Dulan24/Function-Generator/report/Function_Generator[1].pptx

## Analog Function Generator

Group 25
- 200148M DOMBAWALA D.P.C.L.
- 200356A LOKUGEEGANA D.L.
- 200511V RANASINGHE R.A.R.L
- 200741B YAPA Y.A.N.T.

## Circuit Diagram

Triangular and Saw-tooth

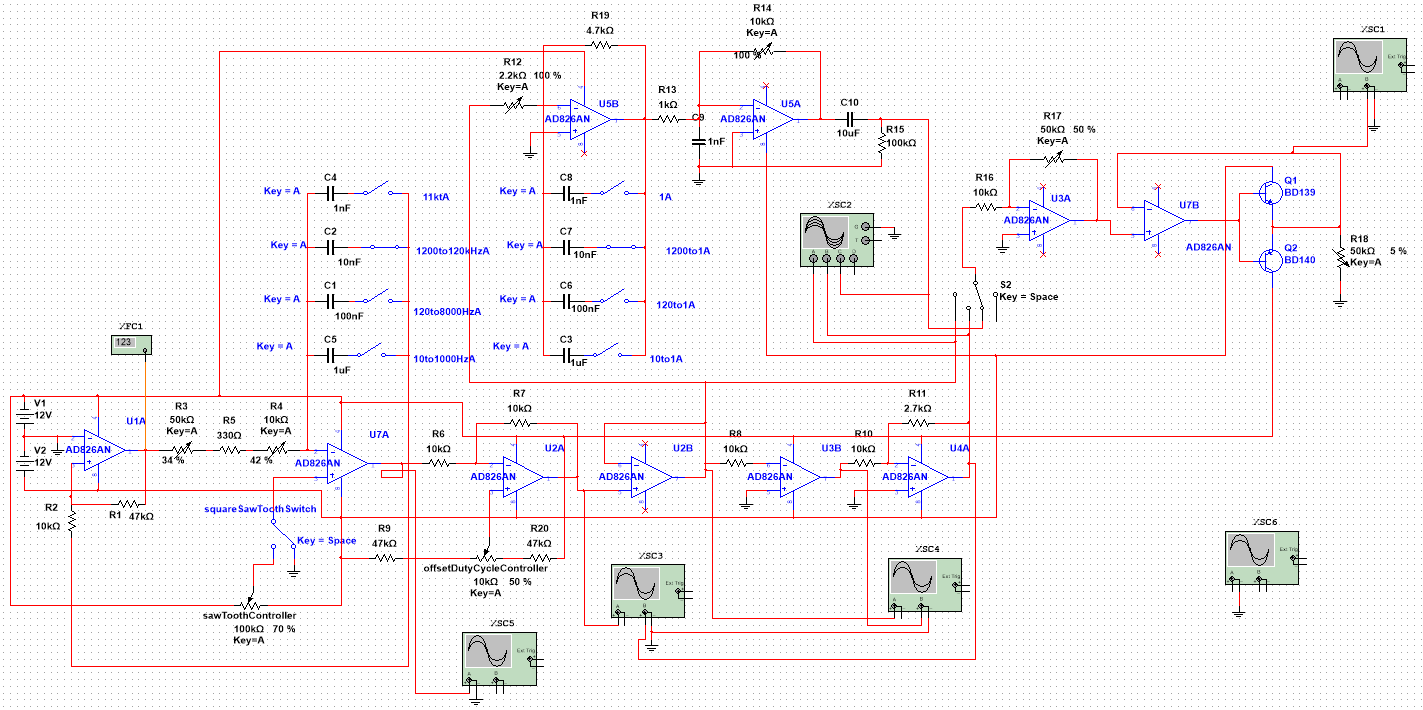
[picture p1: figure]

Sine wave

Square wave

## Circuit

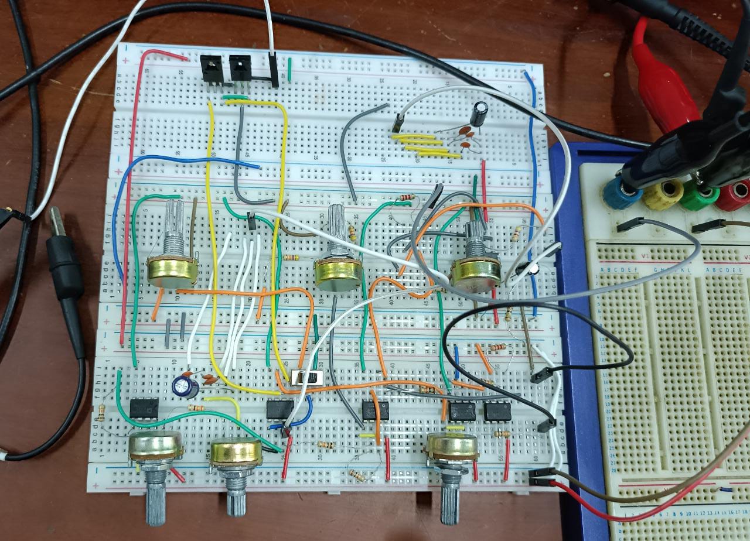
[picture p2: figure]

## PCB Design

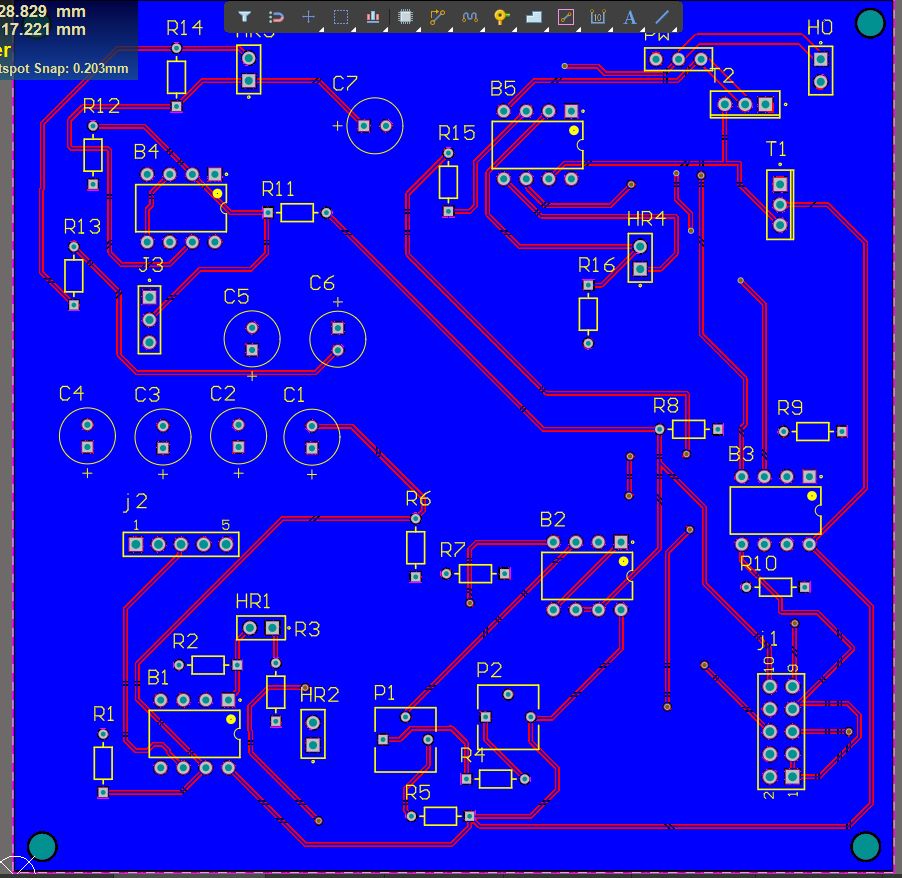
[picture p3: figure]
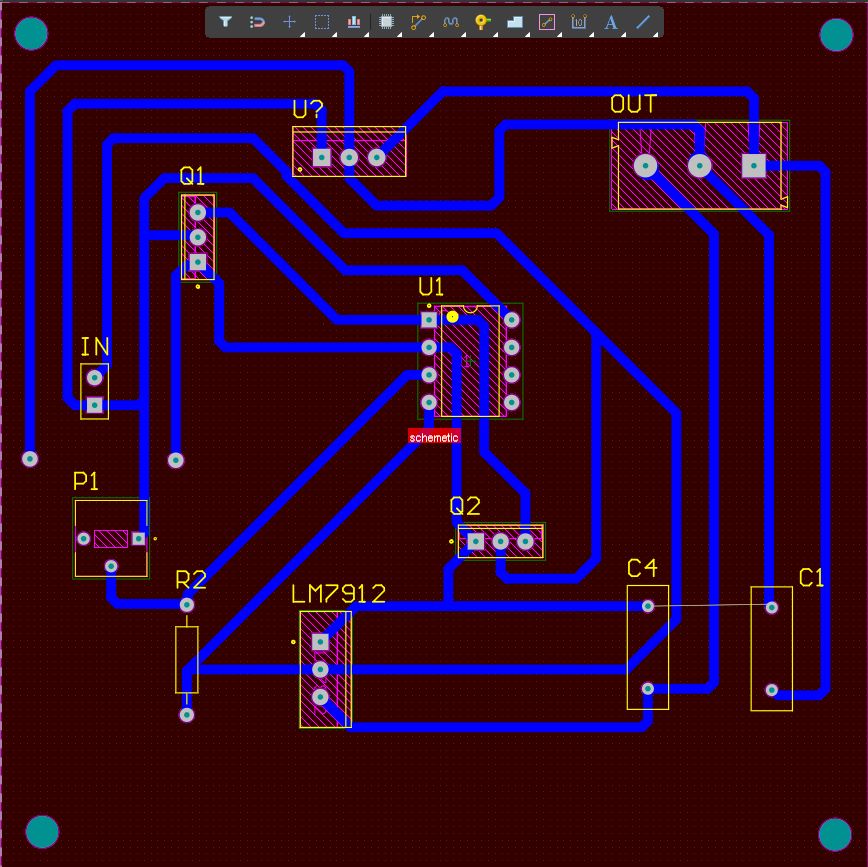
[picture p4: figure]
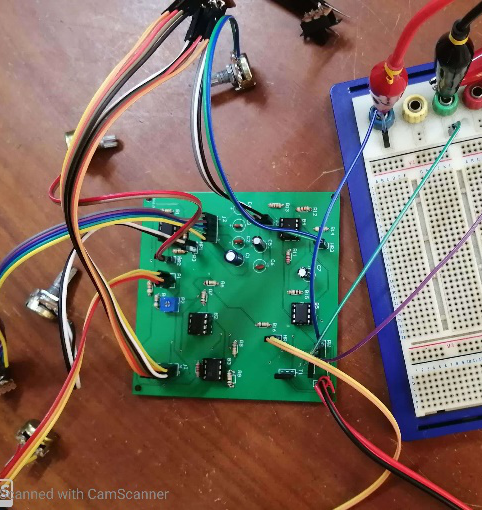
[picture p5: figure]

Main PCB

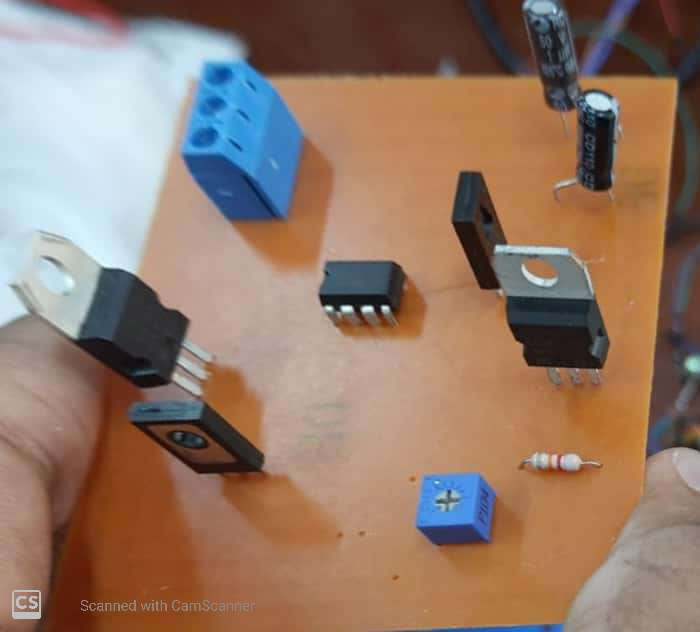
[picture p6: figure]

Power Supply Circuit

## Block Diagram

Triangular and saw-tooth

Frequency Selection

Square wave

Duty Cycle Change

Saw-tooth / Triangle Selection

Schmitt Trigger

Integrator

Triangular wave

Offset

Comparator

Attenuator

Triangular Saw-tooth wave

Mode Selection

Sine wave

Frequency Selection

Integrator

Square wave

Amplifier

Push Pull
circuit

Sine wave

Amplifier

## Triangular & saw tooth wave

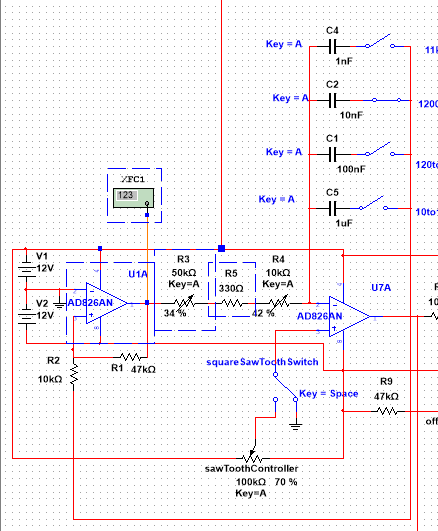
[picture p7: figure]

Using Schmitt trigger circuit and integrator circuit, triangular wave and saw-tooth wave

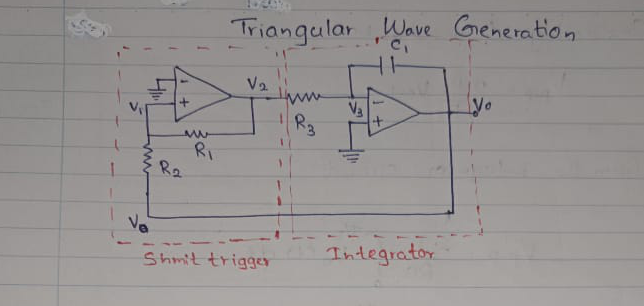
[picture p8: figure]

## Triangular & saw tooth wave

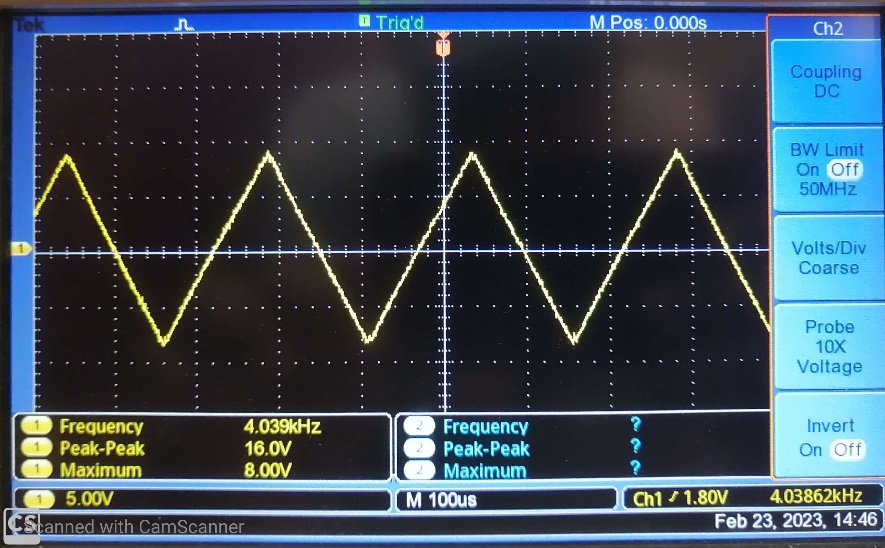
[picture p9: figure]
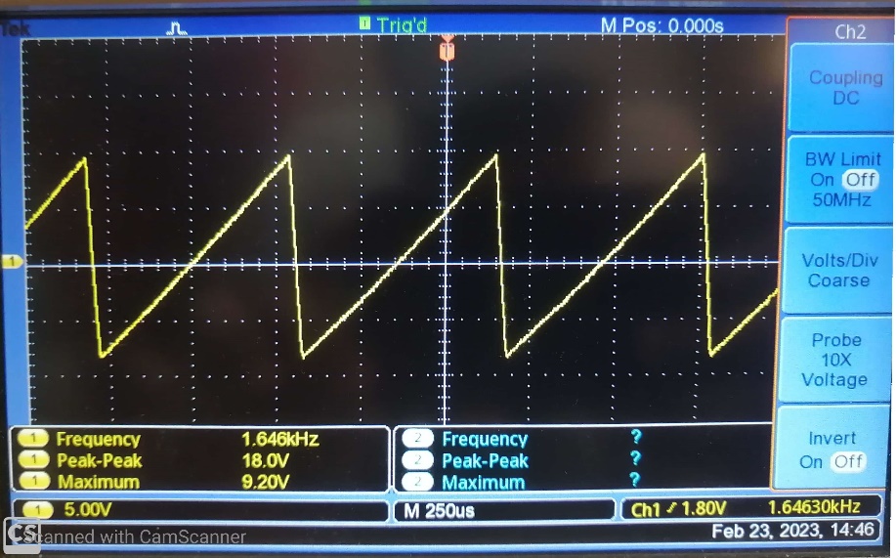
[picture p10: figure]

## Square wave

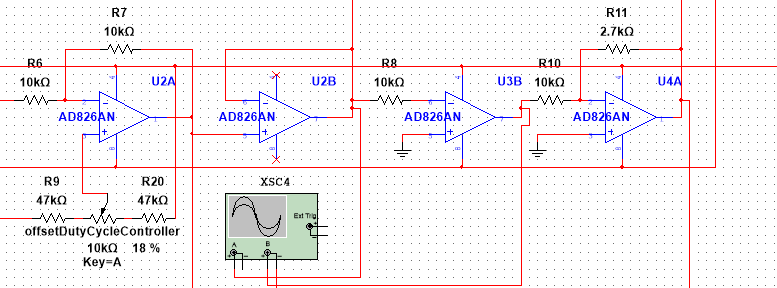
[picture p11: figure]

Triangular Wave

Square Wave

- Using a comparating with a triangular wave without an offset, we generate square wave with 50% duty cycle.
- Using a comparating with a a triangular wave with an variable offset, we generate square wave with variable duty cycle.

## Square wave

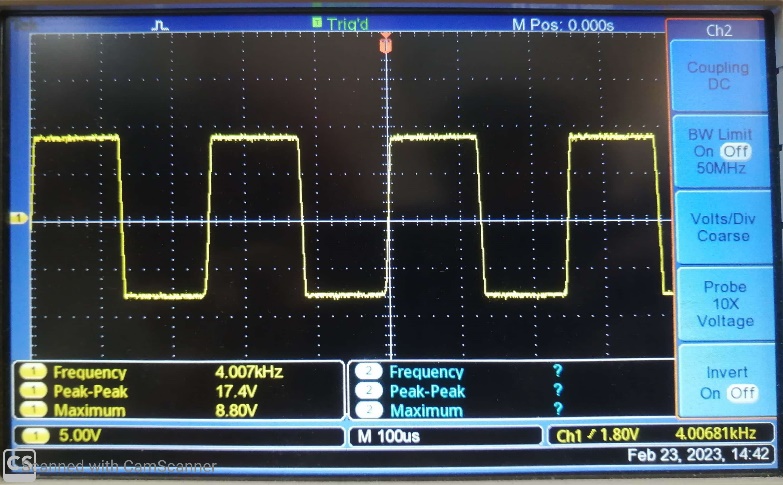
[picture p12: figure]

Triangular Wave

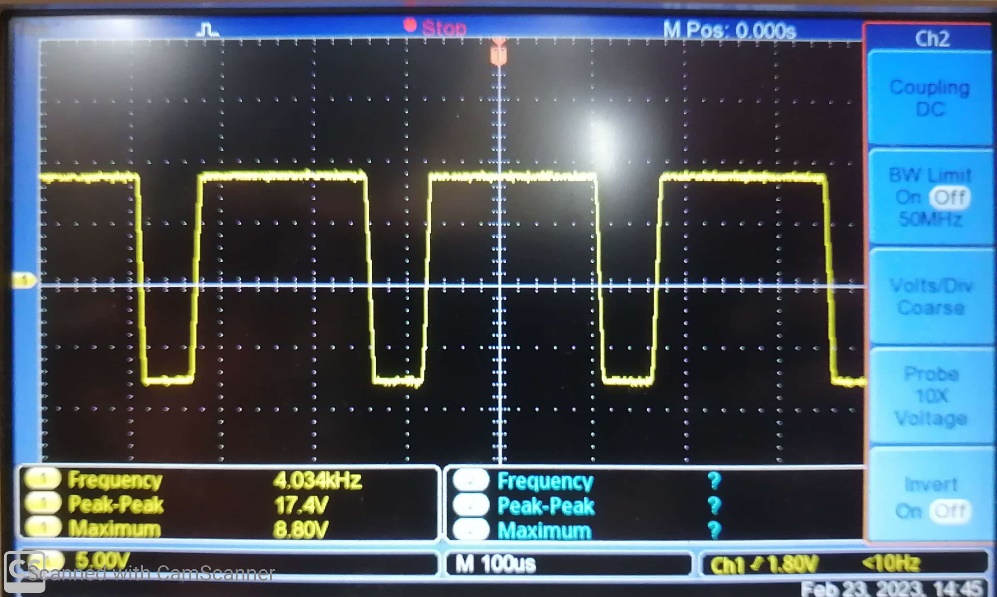
[picture p13: figure]

## Sine wave

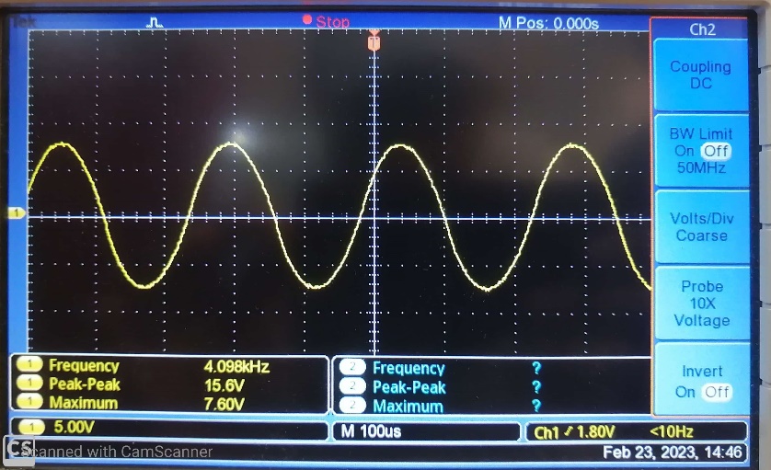
[picture p14: figure]

Triangula Wave

## Sine wave

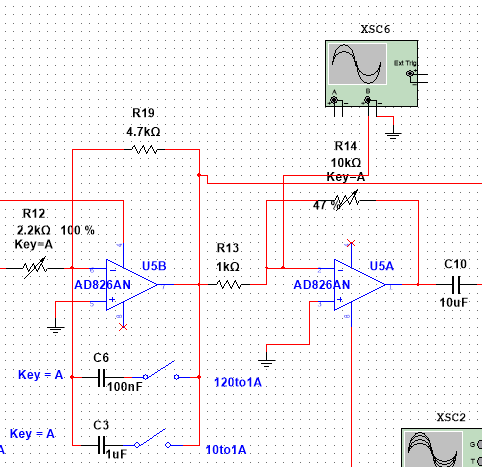
[picture p15: figure]

Sine Wave

v=−1/RC∫ v_(in)

Triangular Wave

Integrating the triangular wave, we obtain approximation to the sine wave.

## Component Selection

OpAmp | Slew rate v/µs (Data Sheet Value) | Practical v/µs (Data Sheet Value)
TL072 | 13 | 0.5
NE5535 | 9 | 3
AD826 | 300 | 20

Because we are using a comparator to make the square wave, there should be high slew rate values for a better function generation. Our calculated value of slew rate of the OpAmp is 300.

## Enclosure Design

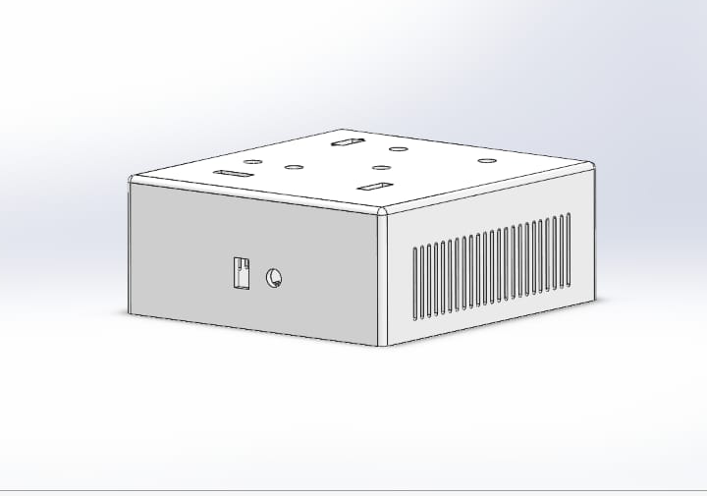
[picture p16: figure]
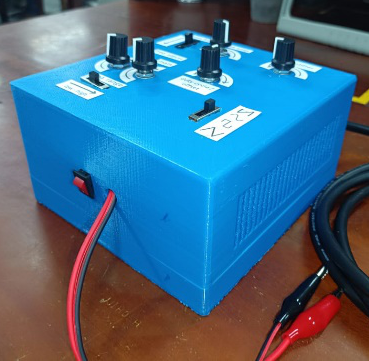
[picture p17: figure]

## Thank you
