Dulan24/Function-Generator/solidworks/SW_/TopLidFinal.SLDPRT

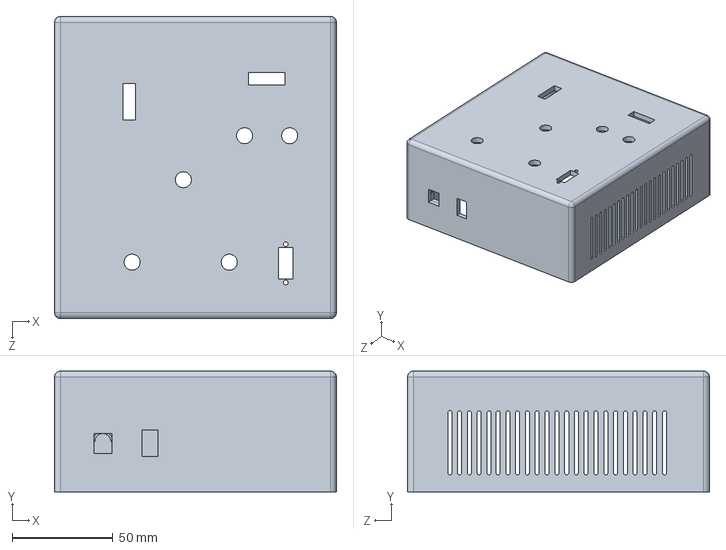
[picture p56: CAD file, 2023-03-30]
solidworks/SW_/TopLidFinal.SLDPRT
140.0 x 60.0 x 150.0 mm
