Dulan24/Function-Generator/solidworks/SW_/bottumLidFinal.SLDPRT

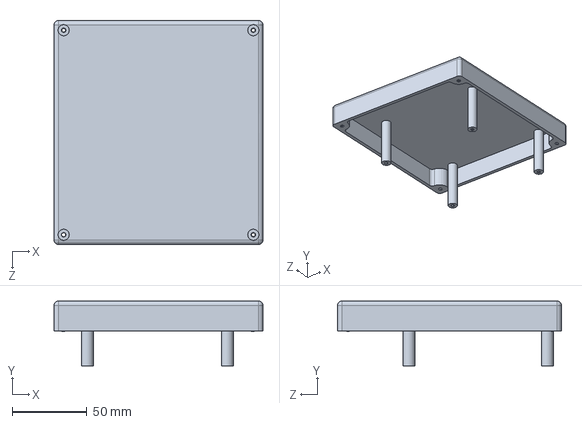
[picture p57: CAD file, 2023-03-30]
solidworks/SW_/bottumLidFinal.SLDPRT
140.0 x 43.5 x 150.0 mm
