Dulan24/Function-Generator/User manual.pdf

## ANALOG FUNCTION GENERATOR

## USER MANUAL

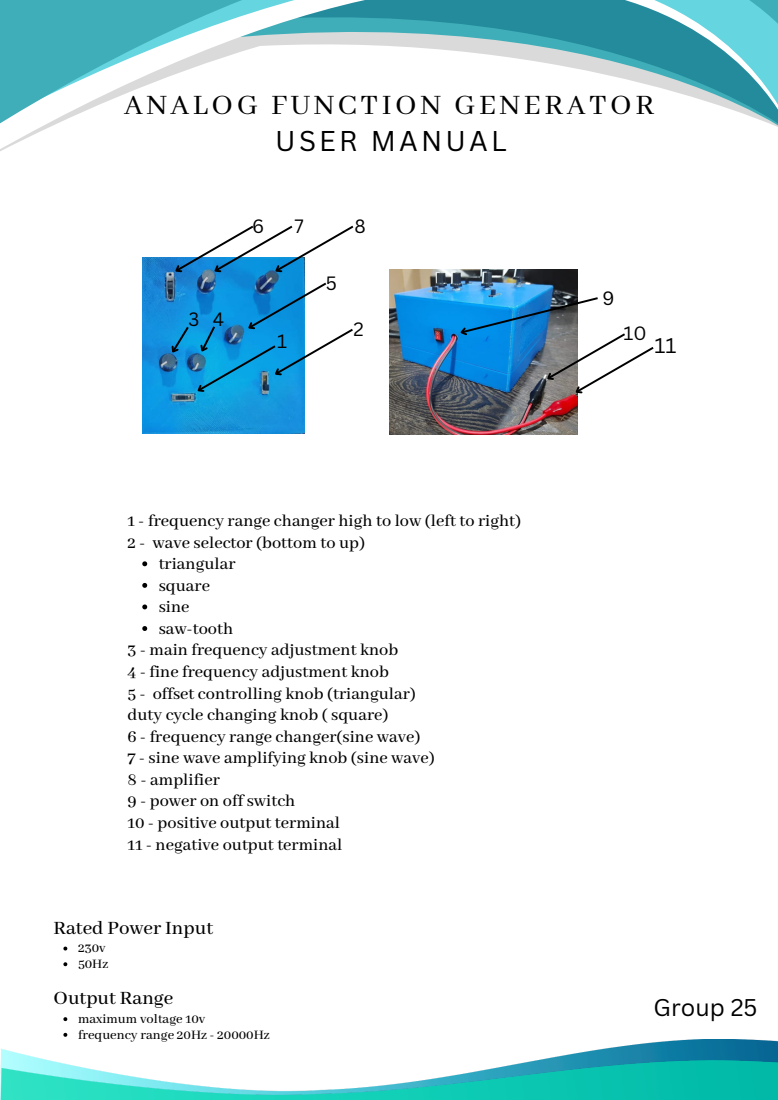
[picture p58: page 1]
maximum voltage 10v frequency range 20Hz - 20000Hz; Rated PowerInput; Output Range; Group 25

1 - frequency range changer high to low (left to right)
2 - wave selector(bottom to up)
triangular
square
sine
saw-tooth
3 - main frequency adjustment knob
4 - fine frequency adjustment knob
5 - offset controlling knob (triangular)
duty cycle changing knob (square)
6 - frequency range changer(sine wave)
7 -sine wave amplifying knob (sine wave)
8 - amplifier
9 - power on offswitch
10 - positive output terminal
11 - negative output terminal
