Dulan24/Function-Generator/(list of files, drawings)

Other design files:
LAB_Project_PCB/LAB_Project_PCB.PrjPcb
LAB_Project_PCB/PCB1.PcbDoc
LAB_Project_PCB/Sheet1.SchDoc
LAB_project_power_PCB/PCB1.PcbDoc
LAB_project_power_PCB/PCB_Project_1.PrjPcb
LAB_project_power_PCB/schemetic.SchDoc
simulation/Design3.ms14
